stanfordroboticsclub/StanfordQuadruped/pupper_controller/src/pupperv2/data/meshes/cone.jpg

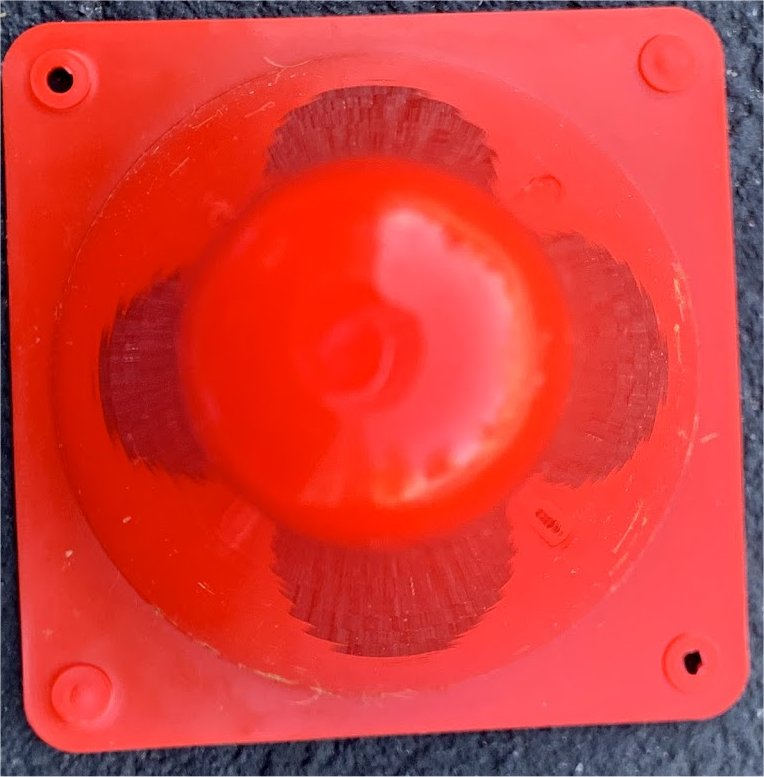
pupper_controller/src/pupperv2/data/meshes/cone.jpg
