stanfordroboticsclub/StanfordQuadruped/pupper_controller/src/pupperv2/data/meshes/IMG_3362 (1).jpg

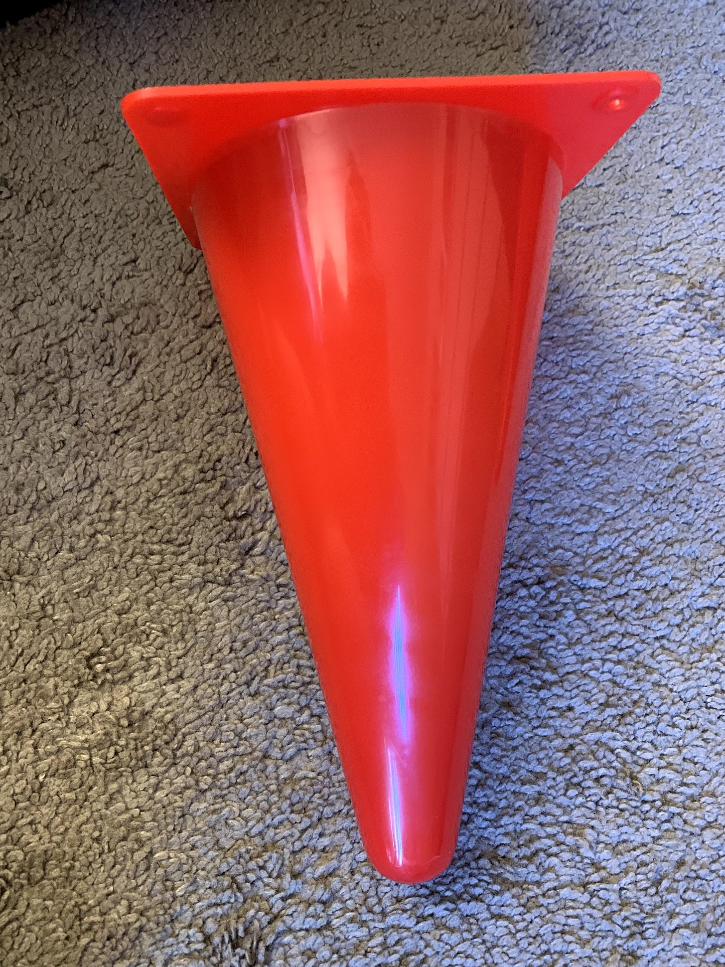
pupper_controller/src/pupperv2/data/meshes/IMG_3362 (1).jpg
