stanfordroboticsclub/StanfordQuadruped/pupper_controller/src/pupperv2/data/meshes/IMG_3370.jpg

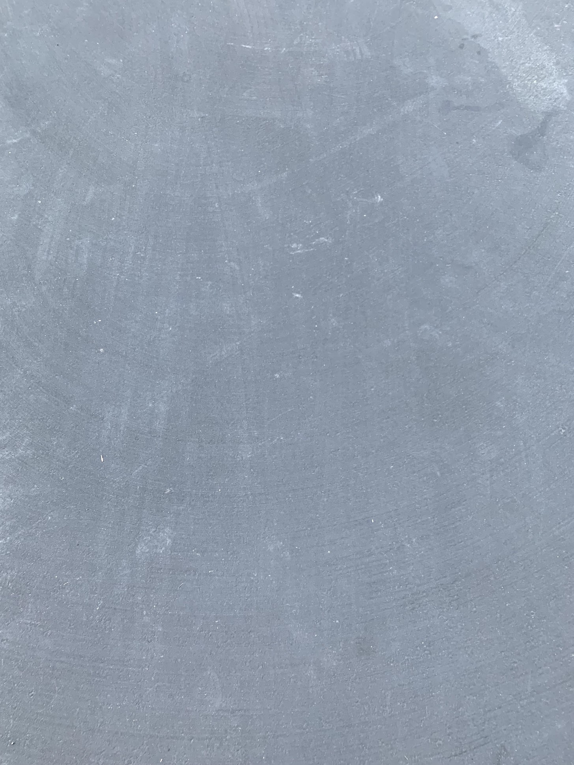
pupper_controller/src/pupperv2/data/meshes/IMG_3370.jpg
