stanfordroboticsclub/StanfordQuadruped/pupper_controller/src/pupperv2/data/meshes/pupper_texture.png

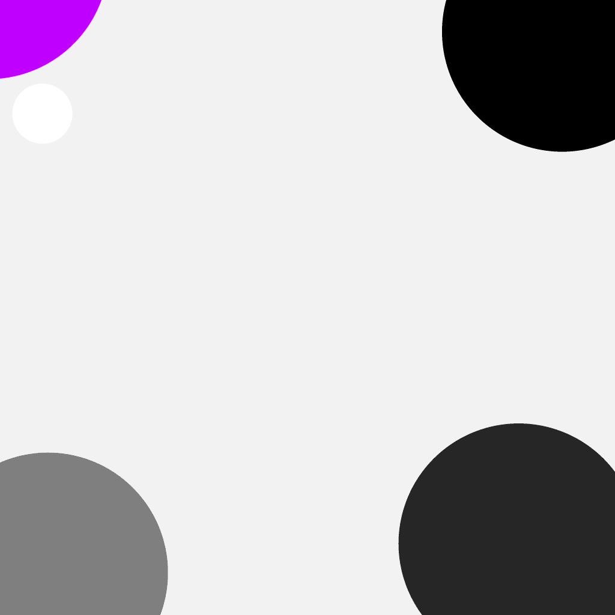
pupper_controller/src/pupperv2/data/meshes/pupper_texture.png
