stanfordroboticsclub/StanfordQuadruped/pupper_controller/src/pupperv2/data/meshes/ramp.jpg

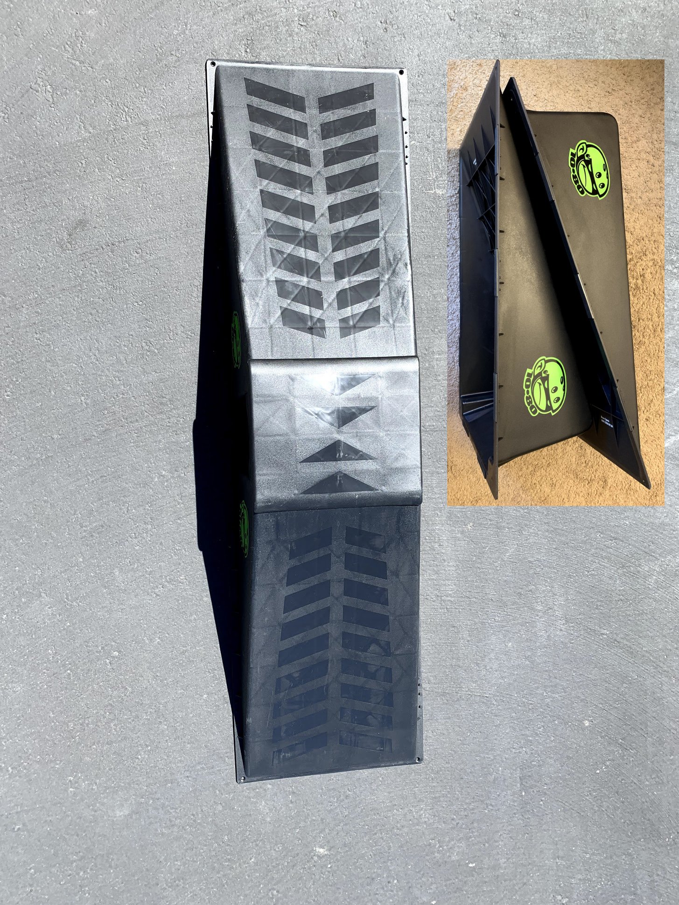
pupper_controller/src/pupperv2/data/meshes/ramp.jpg
