stanfordroboticsclub/StanfordQuadruped/pupper_controller/src/pupperv2/data/meshes/motor_knee_left_front.obj

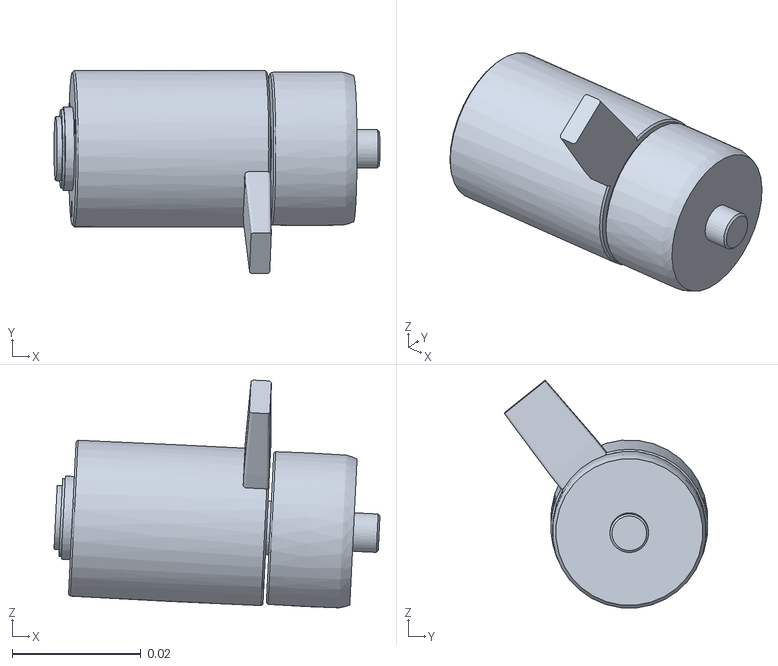
[picture p13: CAD file, 2022-05-15]
pupper_controller/src/pupperv2/data/meshes/motor_knee_left_front.obj
0.0507 x 0.0316 x 0.0354
