stanfordroboticsclub/StanfordQuadruped/pupper_controller/src/pupperv2/data/meshes/chassis_back.obj

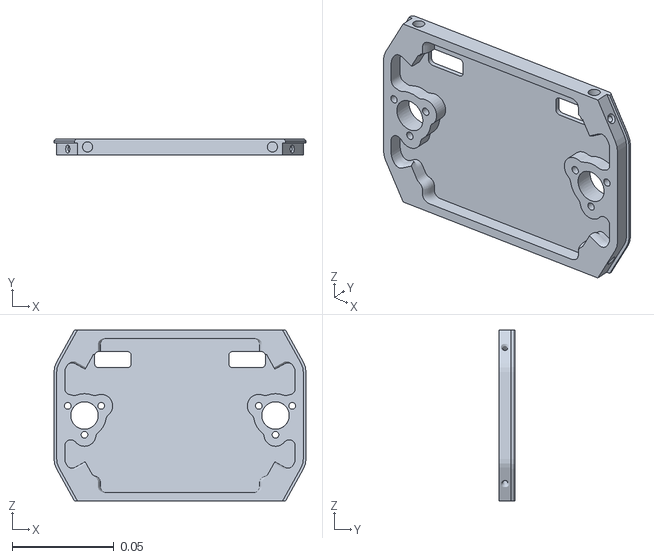
[picture p14: CAD file, 2022-05-15]
pupper_controller/src/pupperv2/data/meshes/chassis_back.obj
0.124 x 0.00805 x 0.084
