stanfordroboticsclub/StanfordQuadruped/pupper_controller/src/pupperv2/data/meshes/upper_leg_left_rear.obj

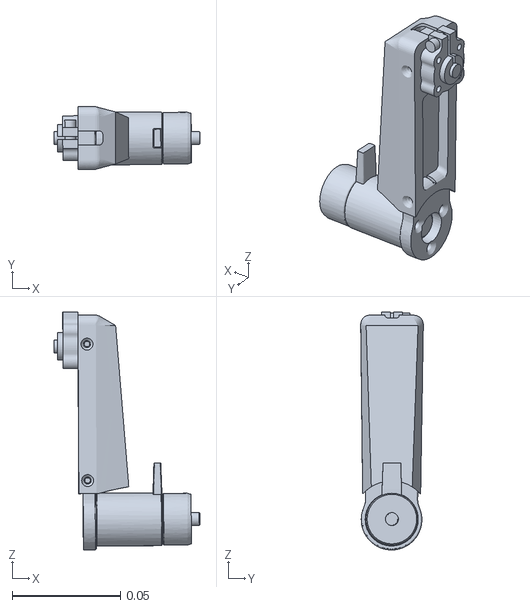
[picture p15: CAD file, 2022-05-15]
pupper_controller/src/pupperv2/data/meshes/upper_leg_left_rear.obj
0.0673 x 0.0289 x 0.11
