stanfordroboticsclub/StanfordQuadruped/pupper_controller/src/pupperv2/data/meshes/Lower_Leg_L.obj

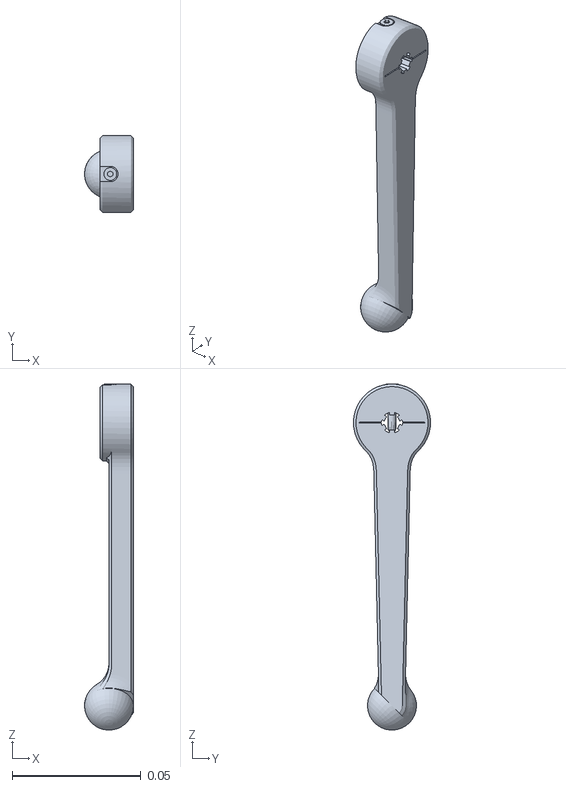
[picture p16: CAD file, 2022-05-15]
pupper_controller/src/pupperv2/data/meshes/Lower_Leg_L.obj
0.019 x 0.03 x 0.134
