stanfordroboticsclub/StanfordQuadruped/pupper_controller/src/pupperv2/data/meshes/chassis_bottom.obj

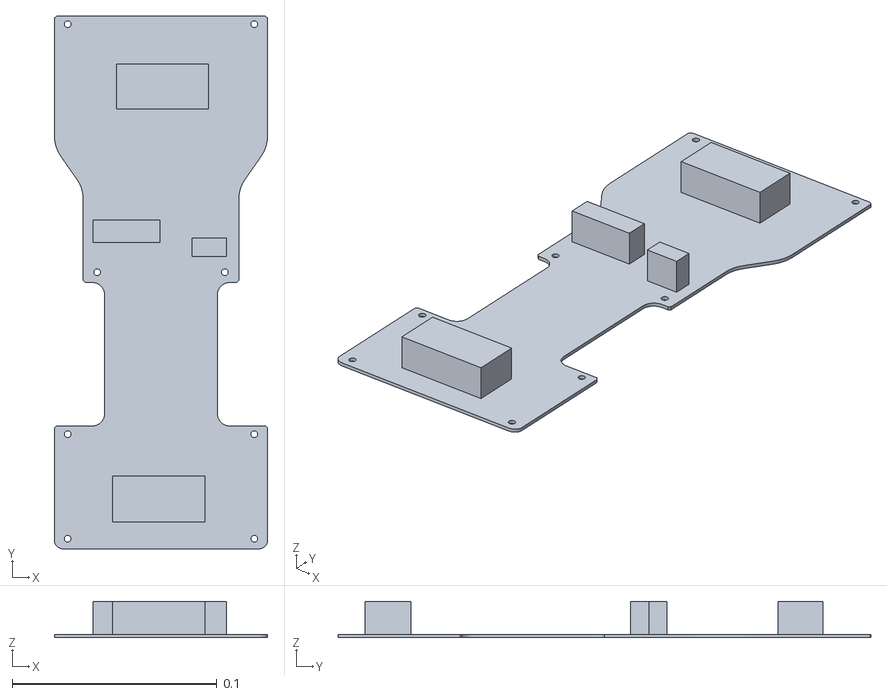
[picture p17: CAD file, 2022-05-15]
pupper_controller/src/pupperv2/data/meshes/chassis_bottom.obj
0.104 x 0.26 x 0.0176
