stanfordroboticsclub/StanfordQuadruped/pupper_controller/src/pupperv2/data/meshes/toe_right_front.obj

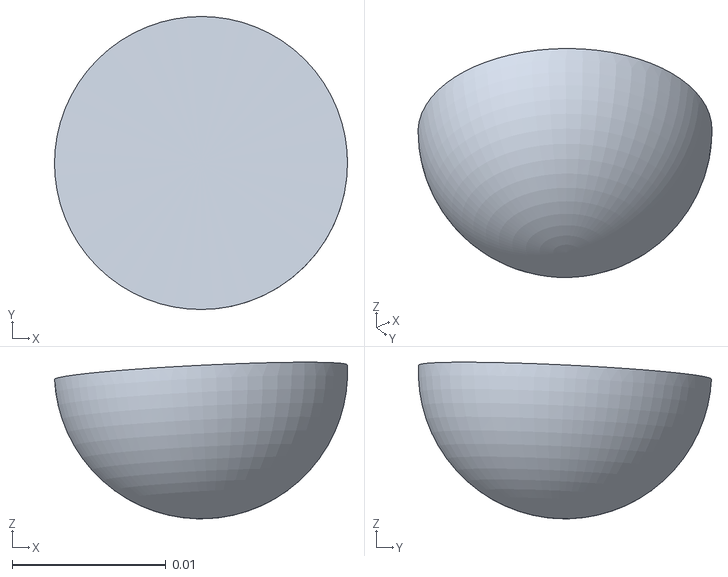
[picture p18: CAD file, 2022-05-15]
pupper_controller/src/pupperv2/data/meshes/toe_right_front.obj
0.019 x 0.019 x 0.0102
