stanfordroboticsclub/StanfordQuadruped/pupper_controller/src/pupperv2/data/meshes/plane.obj

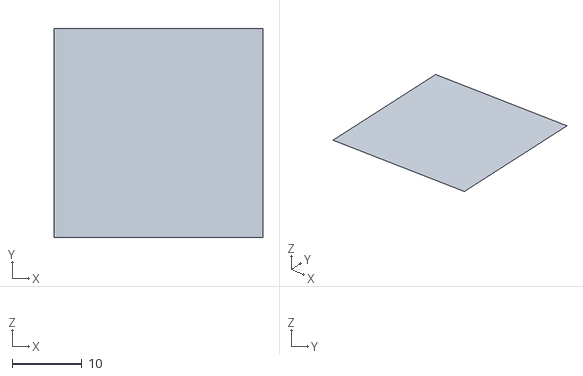
[picture p19: CAD file, 2022-05-15]
pupper_controller/src/pupperv2/data/meshes/plane.obj
30.0 x 30.0 x 0
