stanfordroboticsclub/StanfordQuadruped/pupper_controller/src/pupperv2/data/meshes/ramp.obj

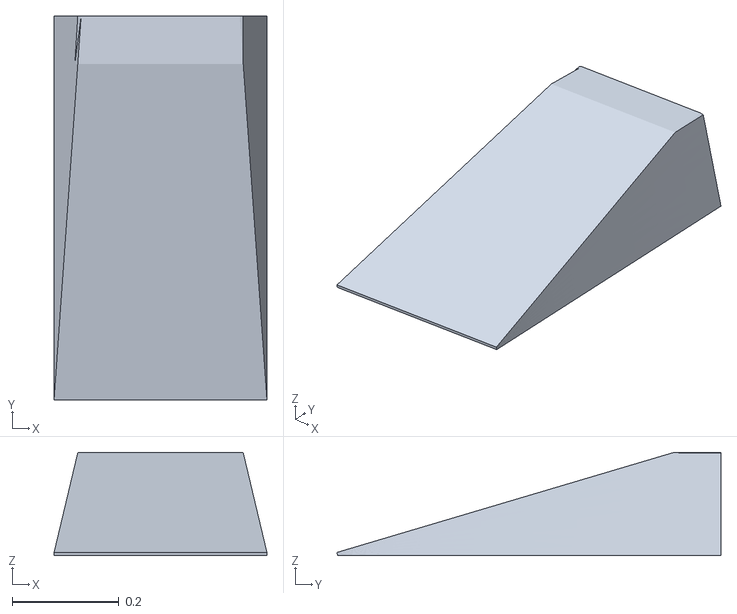
[picture p20: CAD file, 2022-05-15]
pupper_controller/src/pupperv2/data/meshes/ramp.obj
0.4 x 0.721 x 0.194
