stanfordroboticsclub/StanfordQuadruped/pupper_controller/src/pupperv2/data/meshes/chassis_front.obj

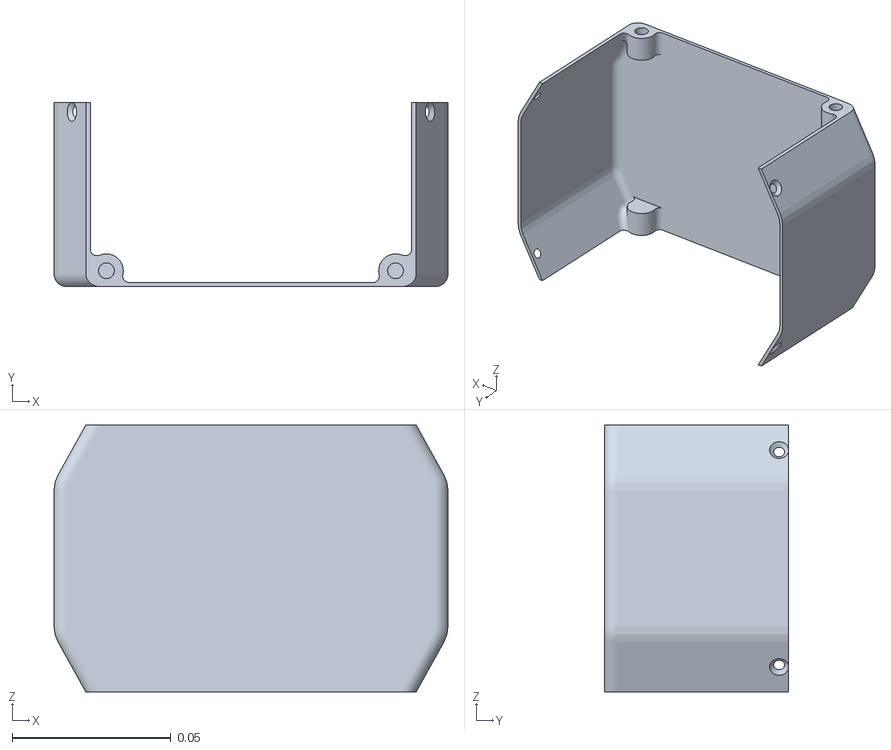
[picture p21: CAD file, 2022-05-15]
pupper_controller/src/pupperv2/data/meshes/chassis_front.obj
0.124 x 0.058 x 0.084
