stanfordroboticsclub/StanfordQuadruped/pupper_controller/src/pupperv2/data/meshes/lower_leg_right_rear.obj

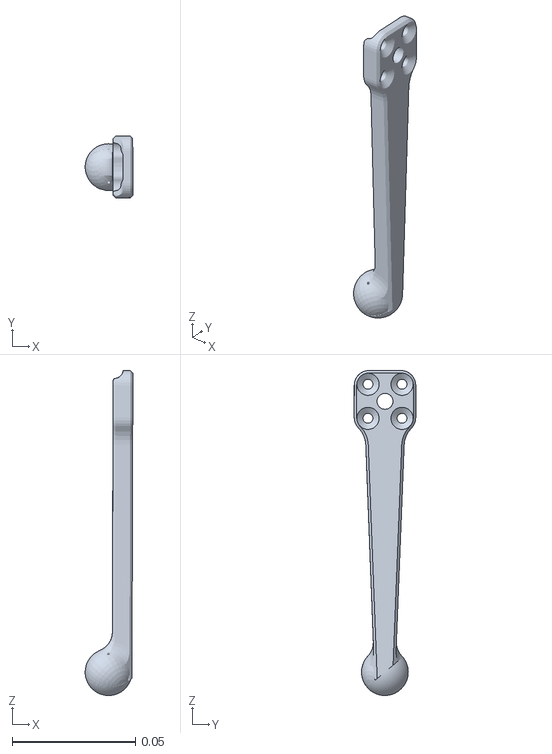
[picture p22: CAD file, 2022-05-15]
pupper_controller/src/pupperv2/data/meshes/lower_leg_right_rear.obj
0.0194 x 0.025 x 0.132
