stanfordroboticsclub/StanfordQuadruped/pupper_controller/src/pupperv2/data/meshes/bracket_right_rear.obj

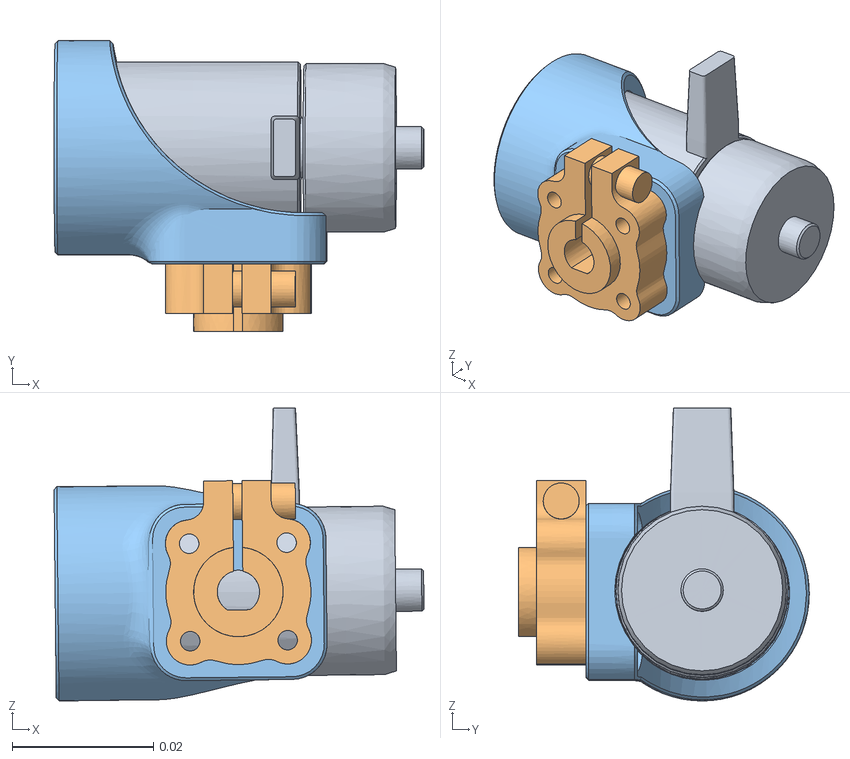
[picture p23: CAD file, 2022-05-15]
pupper_controller/src/pupperv2/data/meshes/bracket_right_rear.obj
0.0525 x 0.0412 x 0.0416
Body1.115_Body1.045
Body1.116_Body1.046
Body1.121_Body1.049
