stanfordroboticsclub/StanfordQuadruped/pupper_controller/src/pupperv2/data/meshes/chassis_top.obj

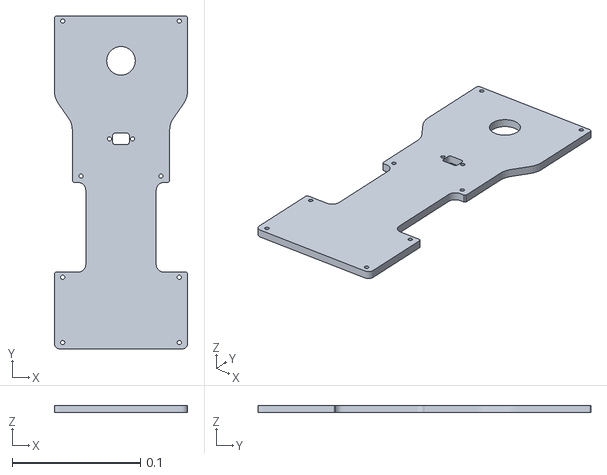
[picture p24: CAD file, 2022-05-15]
pupper_controller/src/pupperv2/data/meshes/chassis_top.obj
0.104 x 0.26 x 0.0058
