stanfordroboticsclub/StanfordQuadruped/pupper_controller/src/pupperv2/data/meshes/bracket_left_rear.obj

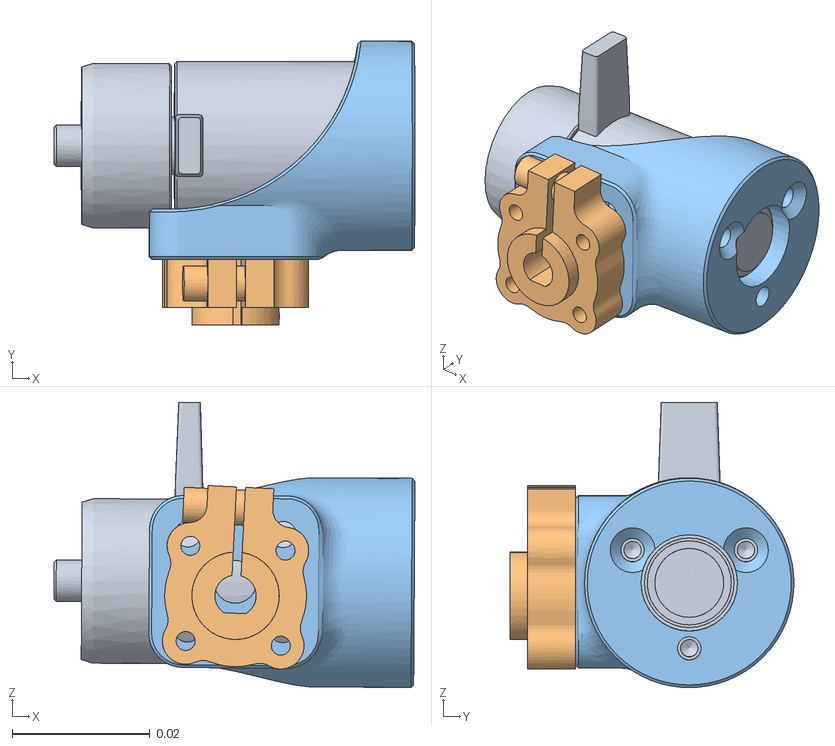
[picture p25: CAD file, 2022-05-15]
pupper_controller/src/pupperv2/data/meshes/bracket_left_rear.obj
0.0524 x 0.0412 x 0.0414
Body1.050_Body1.028
Body1.055_Body1.031
