stanfordroboticsclub/StanfordQuadruped/pupper_controller/src/pupperv2/data/meshes/chassis_left.obj

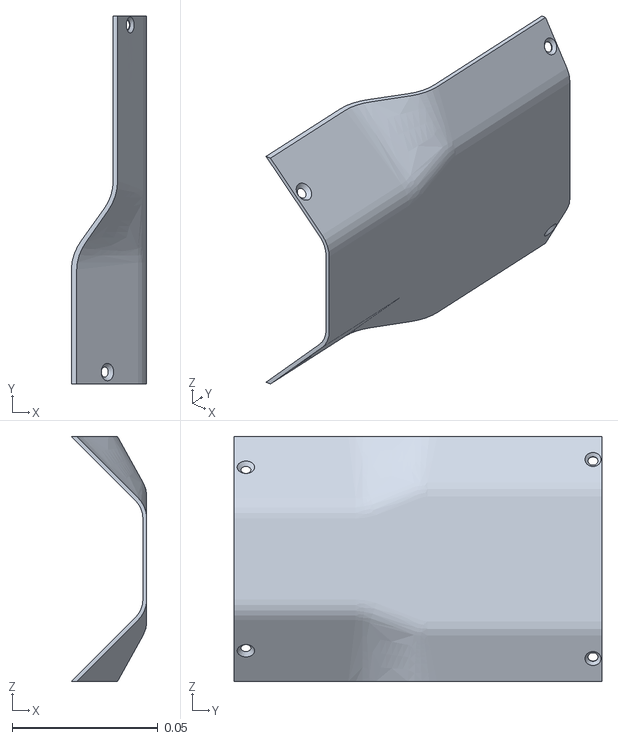
[picture p26: CAD file, 2022-05-15]
pupper_controller/src/pupperv2/data/meshes/chassis_left.obj
0.0259 x 0.126 x 0.084
