stanfordroboticsclub/StanfordQuadruped/pupper_controller/src/pupperv2/data/meshes/motor_knee_left_rear.obj

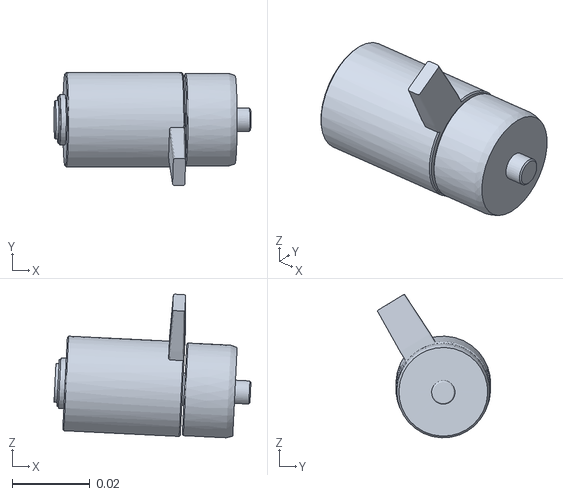
[picture p27: CAD file, 2022-05-15]
pupper_controller/src/pupperv2/data/meshes/motor_knee_left_rear.obj
0.0507 x 0.0292 x 0.037
