stanfordroboticsclub/StanfordQuadruped/pupper_controller/src/pupperv2/data/meshes/concrete_plane.obj

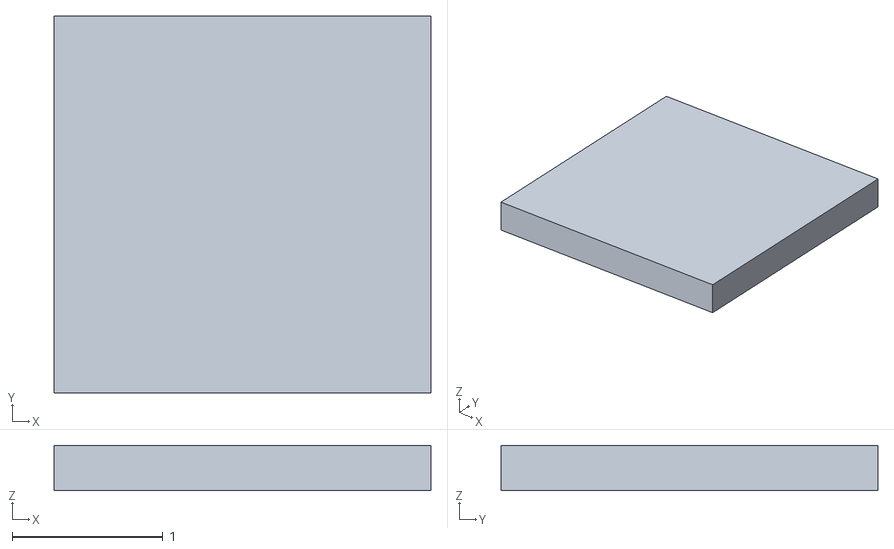
[picture p29: CAD file, 2022-05-15]
pupper_controller/src/pupperv2/data/meshes/concrete_plane.obj
2.50 x 2.50 x 0.3
