stanfordroboticsclub/StanfordQuadruped/pupper_controller/src/pupperv2/data/meshes/motor_right_front.obj

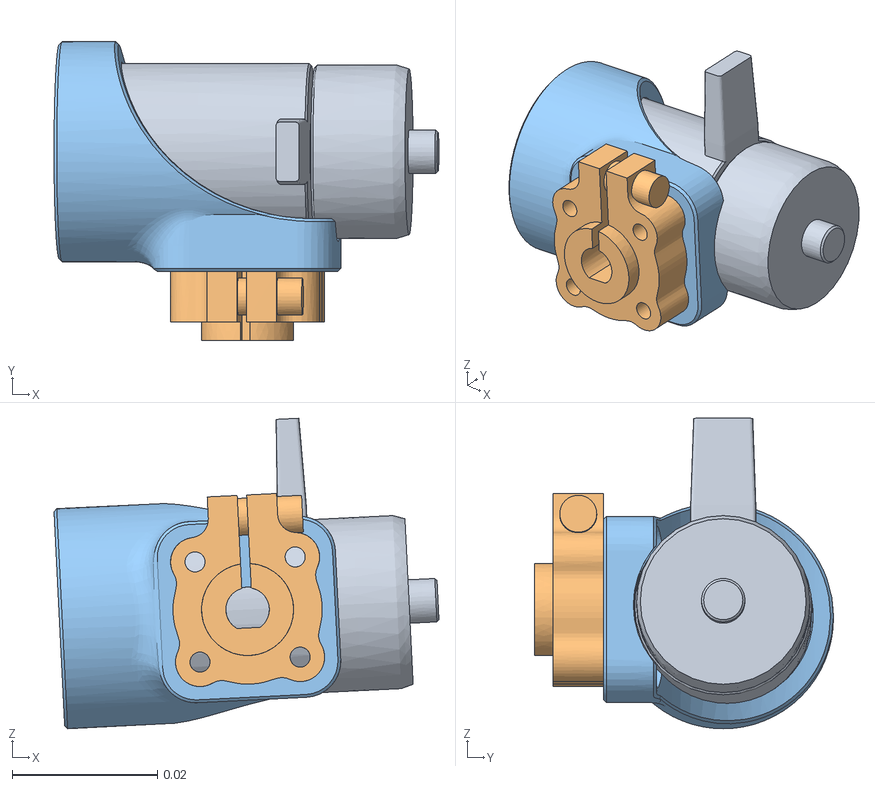
[picture p30: CAD file, 2022-05-15]
pupper_controller/src/pupperv2/data/meshes/motor_right_front.obj
0.0531 x 0.0412 x 0.0428
Body1.153_Body1.066
Body1.154_Body1.067
Body1.159_Body1.070
