stanfordroboticsclub/StanfordQuadruped/pupper_controller/src/pupperv2/data/meshes/cone.obj

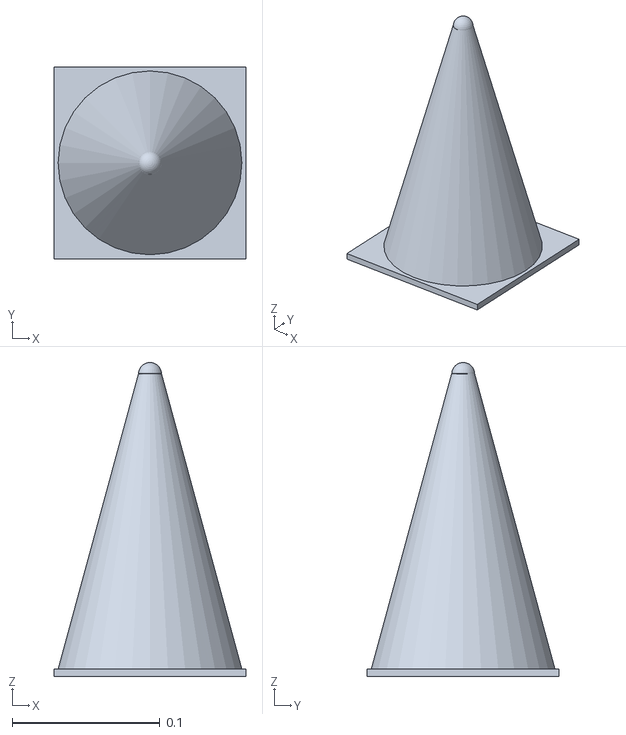
[picture p31: CAD file, 2022-05-15]
pupper_controller/src/pupperv2/data/meshes/cone.obj
0.13 x 0.13 x 0.213
