stanfordroboticsclub/StanfordQuadruped/pupper_controller/src/pupperv2/data/meshes/motor_left_front.obj

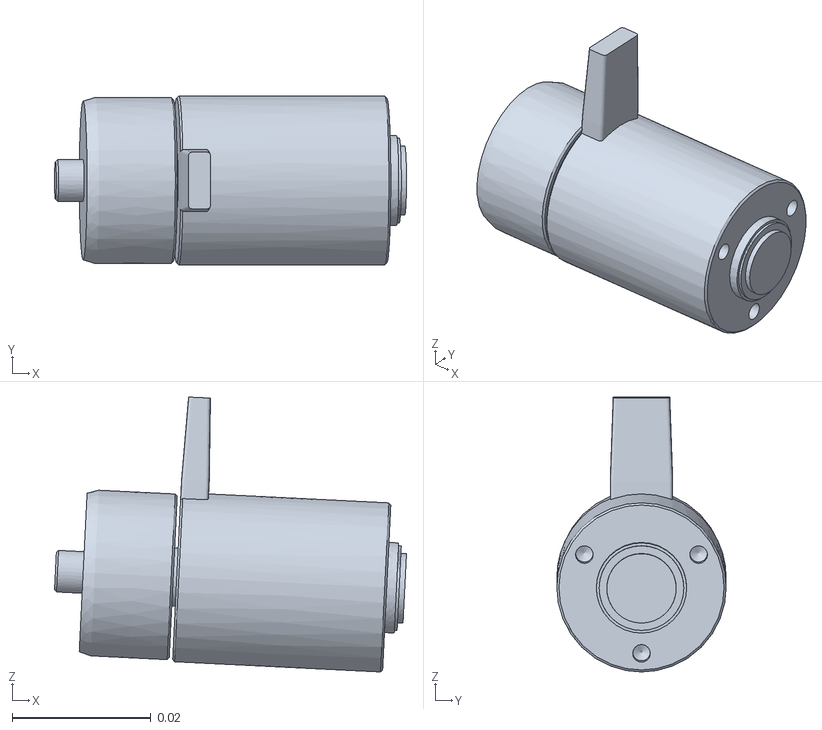
[picture p32: CAD file, 2022-05-15]
pupper_controller/src/pupperv2/data/meshes/motor_left_front.obj
0.0507 x 0.0244 x 0.0396
