stanfordroboticsclub/StanfordQuadruped/pupper_controller/src/pupperv2/data/meshes/upper_leg_right_rear.obj

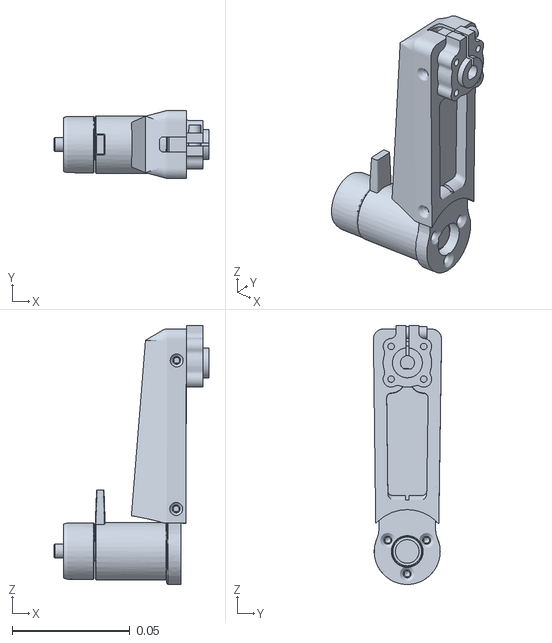
[picture p33: CAD file, 2022-05-15]
pupper_controller/src/pupperv2/data/meshes/upper_leg_right_rear.obj
0.0656 x 0.0289 x 0.11
