stanfordroboticsclub/StanfordQuadruped/pupper_controller/src/pupperv2/data/meshes/bracket_left.obj

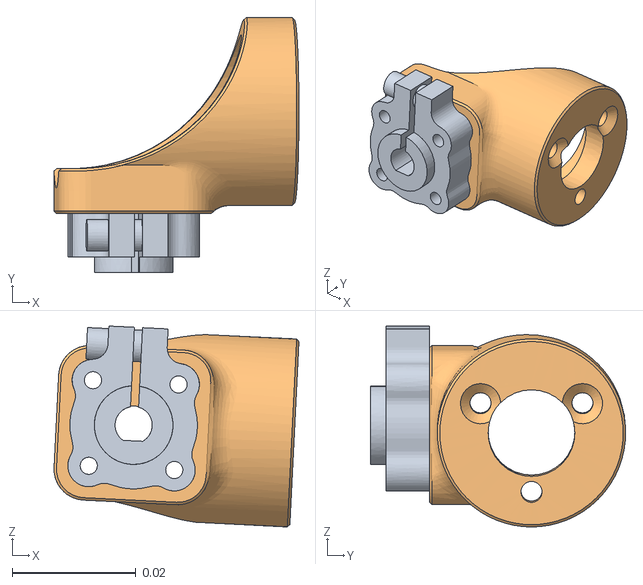
[picture p34: CAD file, 2022-05-15]
pupper_controller/src/pupperv2/data/meshes/bracket_left.obj
0.0396 x 0.0412 x 0.0325
Body1.082_Body1.028
Body1.087_Body1.042
