stanfordroboticsclub/StanfordQuadruped/pupper_controller/src/pupperv2/data/meshes/lower_leg_left_rear.obj

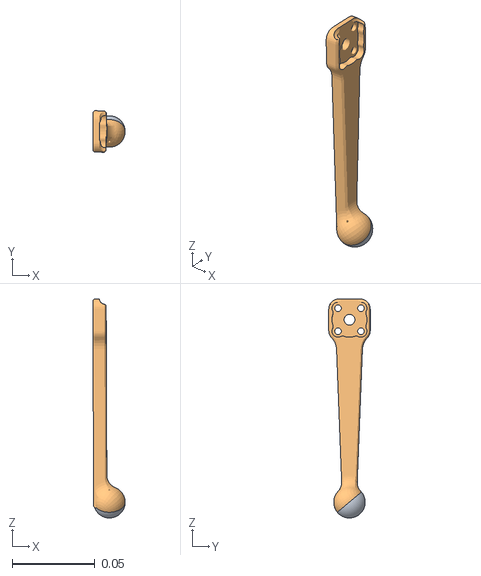
[picture p35: CAD file, 2022-05-15]
pupper_controller/src/pupperv2/data/meshes/lower_leg_left_rear.obj
0.0196 x 0.025 x 0.132
Body1.070_Body1.001
