stanfordroboticsclub/StanfordQuadruped/pupper_controller/src/pupperv2/data/meshes/Cube.003.obj

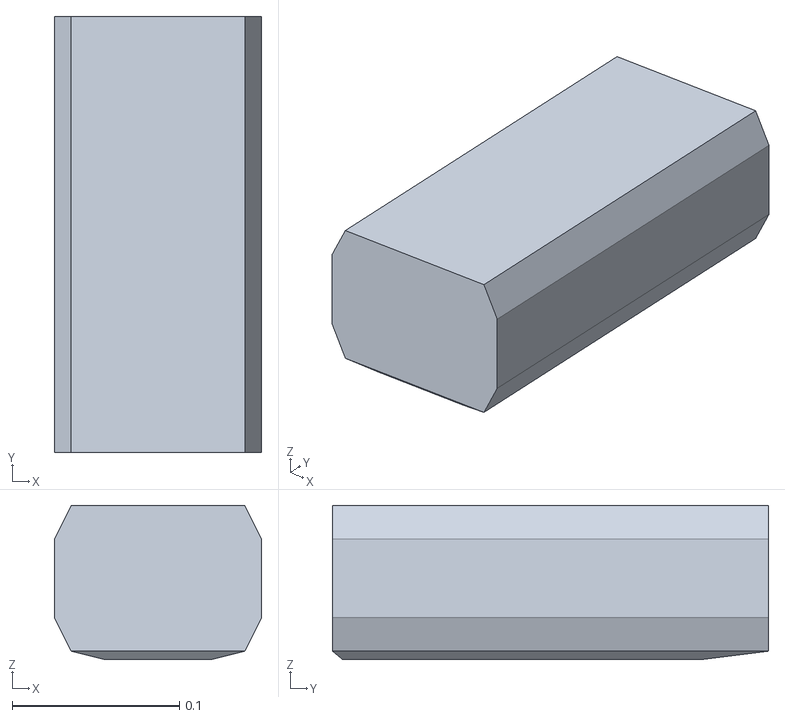
[picture p36: CAD file, 2022-05-15]
pupper_controller/src/pupperv2/data/meshes/Cube.003.obj
0.124 x 0.261 x 0.0922
