stanfordroboticsclub/StanfordQuadruped/(list of files, cad)

Other CAD files:
pupper_controller/src/pupperv2/data/meshes/chassis_right.obj
pupper_controller/src/pupperv2/data/meshes/motor_left_rear.obj
pupper_controller/src/pupperv2/data/meshes/motor_knee_right_front.obj
pupper_controller/src/pupperv2/data/meshes/toe_left_front.obj
pupper_controller/src/pupperv2/data/meshes/motor_right_rear.obj
pupper_controller/src/pupperv2/data/meshes/Lower_Leg_R.obj
