stanfordroboticsclub/StanfordQuadruped/(threads)

Thread 8 (2020-04-11):

Simulated Pupper looks like it is stepping on an invisible object

222464, 2020-04-11:
When the Pupper simulator (sim branch) is run, and one looks at the robot from the side view, one can see that the physics are a bit wonky for the front legs. It looks like it is stepping on some invisible object over and over. I am not sure what causes this, my first thought was that the inertia tensor might be off. But, after playing with that a bit I don't think that is the case.

Nate711, 2020-04-11:
Good catch, I'm guessing pybullet is incorrectly parsing the mjcf.

222464, 2020-04-12:
Some things I discovered:

- The original MJCF file has damping factors over 1. I don't think this is permitted in Bullet, not sure why it works still actually - my guess is that it overshoots the damping in a way that makes it nearly equivalent to a damping value between 0 and 1. Interestingly, it does NOT work when the MJCF is converted to URDF (using the pybullet converter), probably since the conversion clamped it. I had to go in and reducing the damping values, as they should be, since during the conversion they became clamped to 1.0 (unstable) which led the model to bug around and fly through the air. I recommend fixing the damping values to either 0 or some small value like 0.01 in the original file.

- The issue of the "invisible object" still appears, but differently, when converted to URDF. I thought it might still be the moments, so I created a moment recalculation script (with xmltodict) that goes through and updates the inertia tensors using the formulas from Wikipedia. Unfortunately, this made no difference it seems - it still looks like it gets stuck on some invisible object.

- The AI I wrote can compensate for the weird buggy physics, but it would of course be nice to fix the simulation itself!

I'll let you know if I find anything else!

Thread 9 (2020-04-12):

IMU use / not use

SteveMacenski, 2020-04-12:
Hi,

I see IMU code in here but you mentioned you didn't seem to think it helped much. Can you detail that here (publicly for others in the future)? It seems as pupper and derivatives of work of it, an IMU would be necessary for feedback on achieving target poses in the absence of other external sensing. Maybe also for future work in stabilization.

Nate711, 2020-04-18:
If you enable the IMU, the controller will gimbal the legs in space to cancel out the body's orientation. Imagine how a chicken stabilizes it's head as you move the body around, except here, replace the chicken head with the robot feet. In other words, if you pick up the robot and tilt it around, the robot feet will still be walking on the horizontal plane.

The goal with this method was to make the robot always put the feet down perfectly on the ground, even if the body was rotated. However, the downside is that there was essentially no restoring force on the body to bring it back to level, it would just stay tilted and walk tilted. We didn't really like this behavior, even though it walked a little bit better with this method, so we have the IMU turned off by default.

This is as of commit 8a71: https://github.com/stanfordroboticsclub/StanfordQuadruped/blob/8a719e2df52dee91e64049c553eb4293d3d6274a/src/Controller.py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

Thread 12 (2020-06-18):

Inverse Kinematic for a single leg

boehm-e, 2020-06-18:
Hi,
I'm trying to create a small robot which has the same disposition of servos.
I'm struggling with the 3DOF IK (2d works), so I tried to implement yours (for now with javascript for testing).
I transpiled your Python code to Javascript, created a simple leg simulation in Three.js, and i tried to call you function **leg_explicit_inverse_kinematics** with custom x,y,z values :
i changed
`(x, y, z) = r_body_foot`
to
`x=... y=..., z=...`

It outputs me 3 angles, but when I put them in my leg simulation, it goes to a wrong x,y,z location.

My Parameters :
```
ABDUCTION_OFFSET = 4
LEG_L1 = 9.2
LEG_L2 = 10
```
--> [the simulation](https://codepen.io/boehm_e/pen/GRorKxY) : you can see at the bottom, I call **pupperIk(19.2, 0, 4);** which should place the arm straight, but it outputs : [98.11, -81.89, -89.99] which put my feet to the wrong location (obviously).

--> My implementation of you IK in Js is correct : i have compared my js result to you python results.

--> does it have something to do with the r_body_foot variable ?

What I would like to know, is how to use your formula to do IK of one leg independently of any other legs (the coxa being the origin ?) ?

Thank you :)

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

boehm-e, 2020-06-18:
And here is [the IK as a gist](https://gist.github.com/boehm-e/8f16466676f6b82d80d28c4fa9e4f488)

CrazyAZ, 2020-06-18:
I can take a closer look at this later if you’re still having issues, but here’s my initial thoughts:

I do think you may be misunderstanding what the r_body_foot variable is. In our code it is the Cartesian coordinates of the foot with respect to the top of the first link. x is how far forward the foot is. y is how far to the right it is. And z is how far down the leg extends.

So in order for your leg to point straight down you would use (0, 0, 19.2). (Note that this is a singularity, and our code will clip the the value going into arccos to prevent full extension)

One last thing I would be cautious about when applying our inverse kinematics to your leg: our servo for the lower link does not rotate with the top link. Because of this you may need to add/subtract the angle of the top link to get the angle you need for that servo.

CrazyAZ, 2020-06-18:
I can take a closer look at this later if you’re still having issues, but here’s my initial thoughts:

I do think you may be misunderstanding what the r_body_foot variable is. In our code it is the Cartesian coordinates of the foot with respect to the top of the first link. x is how far forward the foot is. y is how far to the right it is. And z is how far down the leg extends.

So in order for your leg to point straight down you would use (0, 0, 19.2). (Note that this is a singularity, and our code will clip the the value going into arccos to prevent full extension)

One last thing I would be cautious about when applying our inverse kinematics to your leg: our servo for the lower link does not rotate with the top link. Because of this you may need to add/subtract the angle of the top link to get the angle you need for that servo.

boehm-e, 2020-06-18:
Oh ! Thank you @CrazyAZ (i'm new to IK, and robotics in general)
So I updated the [codepen](https://codepen.io/boehm_e/pen/GRorKxY?editors=0010)
I see that my axis are messed up x) for now I dont know why, but I will investigate.
What I wonder is why I can't seems to control "how far to the right" the foot is;
In the codepen, I do **pupperIk(i, 6, 4);** i >-10<10 which means (to my weird coordinate system ;)) that the robot feet is constantly at 4cm to the right, is constantly at 6cm down and the foot is far from -10cm to 10cm. This works really well.
My issue is when I try to change the distance from the feet to the right --> I change 4cm to ie 1cm. I expect the feet to be right bellow the coxa/origin (at 1cm i mean). But no it move along some stange line at a weird angle.

[Working with 4cm offset](https://codepen.io/boehm_e/pen/GRorKxY)
[Not working with 6cm offset](https://codepen.io/boehm_e/pen/bGEgVKw?editors=0010)

It does seems that this position is possible for my configuration, do you know what i'm doing wrong ?
Thank you again :)

CrazyAZ, 2020-06-19:
I took a look at your simulations, and I think this may be the result of a bug in your rendering. It appears that your simulation is not rotating the coxa around the correct axis.
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
As you can see from this picture, the coxa is pointed off-axis, resulting in an angled path for the foot. Instead, from this view the coxa should be pointed straight down and be rotating up out of the screen.

boehm-e, 2020-06-19:
@CrazyAZ ,
First, thank you very much, you are really helpfull :)

So I updated the code to fix the coxa's rotation (as I understand it).
Here is the [update codepen](https://codepen.io/boehm_e/pen/PoZWyja) , I just changed the line 46 : now the gamma rotates over the z angle (before it was the x).
So now everything seems to work : I can  move over x,y and z axis.
BUT it is strange --> In your video and ny looking at your model, it dont seems to follow this axis of rotation :/ , mine does not, it rotates as in my previous codepens. Tell me if i'm not clear x)

CrazyAZ, 2020-06-19:
It's a bit hard for me to tell which axis is which in the codepen, so it might be that it is actually the angle of the femur which is off by 90 degrees. I believe we define an angle of 0 degrees to be pointing straight down, so if you have 0 as horizontal that could be what is causing the issue.

Closed 2020-06-25.

Thread 16 (2020-08-04):

Questions about vision sensors

xspkwy, 2020-08-04:
I'm sorry I didn't find any descriptions of vision sensors in the Puppet doc. And are there any vision sensors in the Puppet?
If not, can we attach any vision sensors (or depth sensors, etc.) to the Puppet, and thus they can "see" the world?

Nate711, 2020-09-05:
We don't have documentation on putting vision sensors on the robot but you can totally do that if you want.

Closed 2020-09-05.

Thread 20 (2020-11-09):

joystick.service  error

LittleBookboy12138, 2020-11-09:
Both joystick.service and robot.service  are active, but an error occurred while connecting the PS4 to the Pupper.

The specific questions are as follows:
pi@raspberrypi(rw):~$ sudo systemctl status joystick.service
● joystick.service - Pupper Joystick service
   Loaded: loaded (/boot/appliance/home/pi/PupperCommand/joystick.service; enabl
   Active: activating (auto-restart) (Result: exit-code) since Thu 2019-02-14 10
  Process: 525 ExecStart=/usr/bin/python3 /home/pi/PupperCommand/joystick.py (co
 Main PID: 525 (code=exited, status=1/FAILURE)

gowitty, 2020-12-29:
https://github.com/stanfordroboticsclub/UDPComms
DEFAULT_IP = "10.0.0.255"

ip By default UDPComms sends to the 10.0.0.X subnet, but can be changed to a different ip using this argument.
Set to localhost (127.0.0.1) for development on the same computer.

marx-bryan, 2022-03-19:
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
i have the same question ,still unsolved

mikh3x4, 2022-03-19:
try running `python3 /home/pi/PupperCommand/joystick.py` to run the joystick program without systemd. What does it output?

marx-bryan, 2022-03-19:
> try running `python3 /home/pi/PupperCommand/joystick.py` to run the joystick program without systemd. What does it output?

pi@pi(rw):~/PupperCommand$ sudo python3 joystick.py
Can't get device info: No such device
Traceback (most recent call last):
  File "/usr/local/lib/python3.9/dist-packages/ds4drv/backends/bluetooth.py", line 89, in setup
    subprocess.check_output(["hcitool", "clock"],
  File "/usr/lib/python3.9/subprocess.py", line 424, in check_output
    return run(*popenargs, stdout=PIPE, timeout=timeout, check=True,
  File "/usr/lib/python3.9/subprocess.py", line 528, in run
    raise CalledProcessError(retcode, process.args,
subprocess.CalledProcessError: Command '['hcitool', 'clock']' returned non-zero exit status 1.

During handling of the above exception, another exception occurred:

Traceback (most recent call last):
  File "/home/pi/PupperCommand/joystick.py", line 14, in <module>
    joystick = Joystick()
  File "/usr/local/lib/python3.9/dist-packages/PS4Joystick.py", line 85, in __init__
    backend.setup()
  File "/usr/local/lib/python3.9/dist-packages/ds4drv/backends/bluetooth.py", line 92, in setup
    raise BackendError("'hcitool clock' returned error. Make sure "
ds4drv.exceptions.BackendError: 'hcitool clock' returned error. Make sure your bluetooth device is powered up with 'hciconfig hciX up'.

mikh3x4, 2022-03-19:
have you tired running `hciconfig hciX up` before running that command? Its a bit weird because I think joystick.py should run that on its own but I want to make sure

marx-bryan, 2022-03-19:
sudo hciconfig hciX up
Can't get device info: No such device

marx-bryan, 2022-03-19:
To start with,I didnt use offical img ,instead i used version _2021 bulleyes( 2021-10-30-raspios-bullseye),and followed the offical document to install the software

mikh3x4, 2022-03-19:
It seems like the pi's bluetooth module is not showing up at all. What version of Pi are you using? What's the output of `hcitool dev`?

marx-bryan, 2022-03-19:
raspberry 4b ,pi@pi(rw):~/PupperCommand$ hcitool dev
Devices:
device is blank

mikh3x4, 2022-03-19:
It's possible something changed between raspios versions. A quick googling brings [this](https://forums.raspberrypi.com/viewtopic.php?t=323228) up which suggests early bullseye versions had something wrong with bluetooth. I would recommend updating raspios (it should be possible to do in place without reinstalling) and seeing if that fixes things

marx-bryan, 2022-03-19:
pi@pi(rw):~$ sudo nano /etc/apt/sources.list.d/raspi.list
pi@pi(rw):~$ sudo apt-get update
Hit:1 http://mirrors.tuna.tsinghua.edu.cn/raspbian/raspbian bullseye InRelease
Hit:2 http://mirrors.tuna.tsinghua.edu.cn/raspberrypi bullseye InRelease
Reading package lists... Done
pi@pi(rw):~$ sudo apt-get upgrade
Reading package lists... Done
Building dependency tree... Done
Reading state information... Done
Calculating upgrade... Done
0 upgraded, 0 newly installed, 0 to remove and 0 not upgraded.
pi@pi(rw):~$ sudo hcitool dev
Devices:
still blank
i think maybe i need to reinstall it to the newest version

marx-bryan, 2022-03-19:
> It's possible something changed between raspios versions. A quick googling brings [this](https://forums.raspberrypi.com/viewtopic.php?t=323228) up which suggests early bullseye versions had something wrong with bluetooth. I would recommend updating raspios (it should be possible to do in place without reinstalling) and seeing if that fixes things

thanks for your advice

AlfredMoore, 2023-06-01:
> pi@pi(rw):~$ sudo nano /etc/apt/sources.list.d/raspi.list pi@pi(rw):~$ sudo apt-get update Hit:1 http://mirrors.tuna.tsinghua.edu.cn/raspbian/raspbian bullseye InRelease Hit:2 http://mirrors.tuna.tsinghua.edu.cn/raspberrypi bullseye InRelease Reading package lists... Done pi@pi(rw):~$ sudo apt-get upgrade Reading package lists... Done Building dependency tree... Done Reading state information... Done Calculating upgrade... Done 0 upgraded, 0 newly installed, 0 to remove and 0 not upgraded. pi@pi(rw):~$ sudo hcitool dev Devices: still blank i think maybe i need to reinstall it to the newest version

Did you solve it ? Totally same problem, though I am in the Debian 10.

Thread 21 (2020-12-29):

self.udp_publisher.send ConnectionRefusedError on second call

gowitty, 2020-12-29:
self.udp_publisher.send ConnectionRefusedError on second call
need to restart run_robot.py

pi@raspberrypi:~ $ sudo systemctl status robot
● robot.service - Robot control service
   Loaded: loaded (/home/pi/StanfordQuadruped/robot.service; enabled; vendor preset: enabled)
   Active: failed (Result: exit-code) since Tue 2020-12-29 13:48:23 GMT; 4min 22s ago
  Process: 343 ExecStartPre=/usr/bin/sudo pigpiod (code=exited, status=0/SUCCESS)
  Process: 412 ExecStart=/usr/bin/python3 /home/pi/StanfordQuadruped/run_robot.py (code=exited, status=1/FAILURE)
 Main PID: 412 (code=exited, status=1/FAILURE)

Dec 29 13:48:13 raspberrypi python3[412]:     joystick_interface.set_color(config.ps4_deactivated_color)
Dec 29 13:48:13 raspberrypi python3[412]:   File "/home/pi/StanfordQuadruped/src/JoystickInterface.py", line 94, in set_color
Dec 29 13:48:13 raspberrypi python3[412]:     self.udp_publisher.send(joystick_msg)
Dec 29 13:48:13 raspberrypi python3[412]:   File "/usr/local/lib/python3.7/dist-packages/UDPComms.py", line 53, in send
Dec 29 13:48:13 raspberrypi python3[412]:     self.sock.send(msg)
Dec 29 13:48:13 raspberrypi python3[412]: ConnectionRefusedError: [Errno 111] Connection refused
Dec 29 13:48:13 raspberrypi systemd[1]: robot.service: Main process exited, code=exited, status=1/FAILURE
Dec 29 13:48:23 raspberrypi systemd[1]: robot.service: State 'stop-sigterm' timed out. Killing.
Dec 29 13:48:23 raspberrypi systemd[1]: robot.service: Killing process 410 (pigpiod) with signal SIGKILL.
Dec 29 13:48:23 raspberrypi systemd[1]: robot.service: Failed with result 'exit-code'.

Thread 22 (2021-02-15):

Need update raspbian buster lite to a new version

mangdangDOTnet, 2021-02-15:
Hello,
I bought some Raspberry Pi 4 boards, but can not boot up them using 2019-09-26-raspbian-buster-lite.img, its version is too old, I tried 2020-02-13-raspbian-buster-lite.img, it's OK.
I also tried 2021-01-11-raspios-buster-armhf-lite.img, and found ssh speed is very slow, so now I use 2020-02-13 version, and have not found any issues.
You can find the image versions at the below link,
https://downloads.raspberrypi.org/raspbian_lite/images/
Please help to double confirm,thanks!
Best,
Afreez

Thread 24 (2021-04-13):

Inverse Kinematics

ywyw2015, 2021-04-13:
What is the coordinate system of pupper？What is the sequence of motor control？

Nate711, 2021-06-02:
The coordinate system is fixed to the frame of the robot and centered at the geometric center between the hip axes. Not sure what you mean by sequence of motor control.

artur-iluk, 2022-03-17:
More specific question:
how are oriented axes of pupper? Where points X+axis and so on.

FaboNo, 2022-05-28:
Yes I guess X axis is forward along the main body frame, Y axis perpendicular. However the question is more about the Z axis is oriented up or down?
Thank you for this  astonished work actually

Thread 32 (2022-02-07):

circuit diagram!

haxord7hasib, 2022-02-07:
Anyone please provide me a circuit diagram , which motor will connect which pin raspberry ,which pin will connect the IMU . I am super confused.

marx-bryan, 2022-03-09:
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
as the picture shows

Thread 35 (2022-09-26):

reverse servomotors

ChevalierLouis, 2022-09-26:
hello, how can i reverse the servomoteurs?

Closed 2023-04-16.

Thread 40 (2023-10-22):

How to activate the robot after calibration.

ShubhamBhatt, 2023-10-22:
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

I am able  to calibrate the servo. I am using RPI4 normal raspian OS, not the lite version. When I start the robot service I get this. The controller is connected and the light color even changes but the robot does not work. Servos also do not active. What am I doing wrong. I have attached the screenshot.

Thread 41 (2024-08-19):

Excitement for Pupper v3 Release

SlimeVRX, 2024-08-19:
Dear @Nate711 ,

First of all, thank you for your incredible work and dedication to the Pupper project. Your efforts have been truly inspiring, and I have been following the development of this robotic dog with great interest.

I am particularly excited about the upcoming release of Pupper v3!
The new specifications, including:
- The GIM4305 brushless motors
- Raspberry Pi 5
- The reinforcement learning locomotion policy
- The addition of the Luxonis SR depth camera
- The LCD screen for debugging and facial expressions is also a great touch.
- Roughly $1000 BOM

As someone who is eagerly looking forward to this release, I would greatly appreciate any updates or information you could provide about the progress of Pupper v3. It would be wonderful to stay informed as you move closer to the release.

Best regards,

Tin Nguyen

Closed 2024-08-20.

Thread 42 (2024-08-20):

Anticipation for Pupper v3 Release and Request for Updates

SlimeVRX, 2024-08-20:
Dear Stanford Robotics Club,

First of all, thank you for your incredible work and dedication to the Pupper project. Your efforts have been truly inspiring, and I have been following the development of this robotic dog with great interest.

I am particularly excited about the upcoming release of Pupper v3!
The new specifications, including:
- The GIM4305 brushless motors
- Raspberry Pi 5
- The reinforcement learning locomotion policy
- The addition of the Luxonis SR depth camera
- The LCD screen for debugging and facial expressions is also a great touch.
- Roughly $1000 BOM

As someone who is eagerly looking forward to this release, I would greatly appreciate any updates or information you could provide about the progress of Pupper v3. It would be wonderful to stay informed as you move closer to the release.

Best regards,

Tin Nguyen

SlimeVRX, 2024-08-29:
Hi @Nate711, Please update the plan!

SlimeVRX, 2024-09-01:
Hi @Nate711
Please update!

SlimeVRX, 2024-09-09:
Hi, I apologize for the bother, but could you please let me know the earliest possible time when the Pupper v3 will be open-sourced?

twodawg, 2024-09-09:
I am also excited for the release. The BOM is slowly getting some new items listed. A magnet and an AI RB hat have been added, check it out! I am curious how we will be able to order the motor and controller for such a cheap price.

SlimeVRX, 2024-09-10:
I found information about Drivers controller:
- Custom 200W FOC motor drivers
- Based on MIT Cheetah motor drivers
- Features TI DRV8316 integrated gate driver and FETs. 8A, 40V rated.

I have contacted Steadywin to purchase GIM4305 motors, but Steadywin does not provide the drivers controller.
Could you provide me with more information about the drivers controller and where I can order them?

Nate711, 2024-09-28:
@SlimeVRX Sorry for not replying earlier. Pupper v3 works with the regular Steadywin 4305 motors as well. We haven't finished polishing the custom drivers yet. Once we test the new control board with the AI hat for rpi I'll put the custom pcb manufacturing data online

I think by Jan 2025 the robot will be ready for the public

dougbot01, 2024-12-20:
Was anyone able to locate the STL files to print?
 Thank you!

SlimeVRX, 2025-01-08:
Looking forward to the project release soon!

dougbot01, 2025-03-02:
Hi,

I’m sure you’re hard at work on this, but wondering if there is any way to start building, or if others like myself can support your efforts in any way? I’ve noticed the monorepo but can’t do much without the STL files to print or the fully spec’d out electronics. If there is any way I can help please let me know. I think GitHub will do DM.

SlimeVRX, 2025-03-20:
Hi @Nate711 ,

I've noticed you've made a lot of updates to the Pupper v3 project. I'm really excited about it and was wondering if you have an estimated release date for the project.

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

Additionally, I'm looking for more information about the driver controllers. In the latest Pupper v3.5 BOM Sheet, I noticed that the Steadywin GIM4305 with driver (12 units) costs $1,500, and its percentage in the BOM has increased significantly compared to previous versions. This substantial cost increase might make it more difficult for a wider audience to access and experiment with this research. Could you provide some insights into this change and whether there are any alternative driver options?

Thanks for your hard work on this project! Looking forward to your response.

Nate711, 2025-03-26:
@SlimeVRX Hi, we wanted to use our custom motor drivers which would make the actuator price about $80/piece but we haven't bad the bandwidth to test and incorporate those into the mainline design. So for now you have to use the standard GIM4305-10 from steadywin with the SHS drivers. I'm hoping to negotiate down the price (right now $125/piece) since their volume will increase but TBD.

SlimeVRX, 2025-03-27:
Thanks so much for the information you shared, keep up the good work on this project. I look forward to it!
