stanfordroboticsclub/StanfordQuadruped/(commit log)

2020-01-29 Removed Kinematics import from Controller
2020-02-03 Wrote inverse kinematics for woofer
2020-02-19 Incorporated odrive directions and other fixes
2020-02-20 Switched run_robot to run woofer
2020-02-22 Multithreaded finding odrives
2020-03-01 update the servo calibration script
2020-03-19 fixing calibrate_servos
2020-03-21 Add calibration and notes
2020-10-30 lower yaw rate
2021-05-27 Add support for auto-homing
2021-06-07 don't enable pupper_drive by default (torque control needs more work, use pos/position control, its gains needs more tuning too, in djipupper/DummySerial.py)
2021-07-23 Configure for Raspberry Pi
2021-07-24 Allow wired transmitter connection
2022-05-15 refactor heuristic controller into gym env
    [Cube.003.obj, Lower_Leg_L.obj, Lower_Leg_R.obj, bracket_left.obj, bracket_left_rear.obj, bracket_right_rear.obj, chassis_back.obj, chassis_bottom.obj]
2022-05-17 fix abduction direction
    [Cube.003.obj, Lower_Leg_L.obj, Lower_Leg_R.obj, bracket_left.obj, bracket_left_rear.obj, bracket_right_rear.obj, chassis_back.obj, chassis_bottom.obj]
2022-05-22 add ARS training
    [pupper_no_mesh.urdf]
2022-05-23 remove turtle import (screw you vscode)
2022-05-23 Set friction coefficients of toes to 1.5 in urdf. Change floor friction manually to 1.5.
    [pupper_no_mesh.urdf]
2022-05-23 update friction coeffs to 0.75 because at 1.5 robot didn't move
    [pupper_no_mesh.urdf]
2022-05-24 Fix abduction angles. Add configurable friction. Update package reqs.
    [pupper_no_mesh.urdf]
2022-06-06 correct simulator roll and pitch.
